enginarslangezici/ECU/KENDİ_ECU.kicad_pcb

## KiCad design KENDİ_ECU.kicad_pcb (2026-10-06)

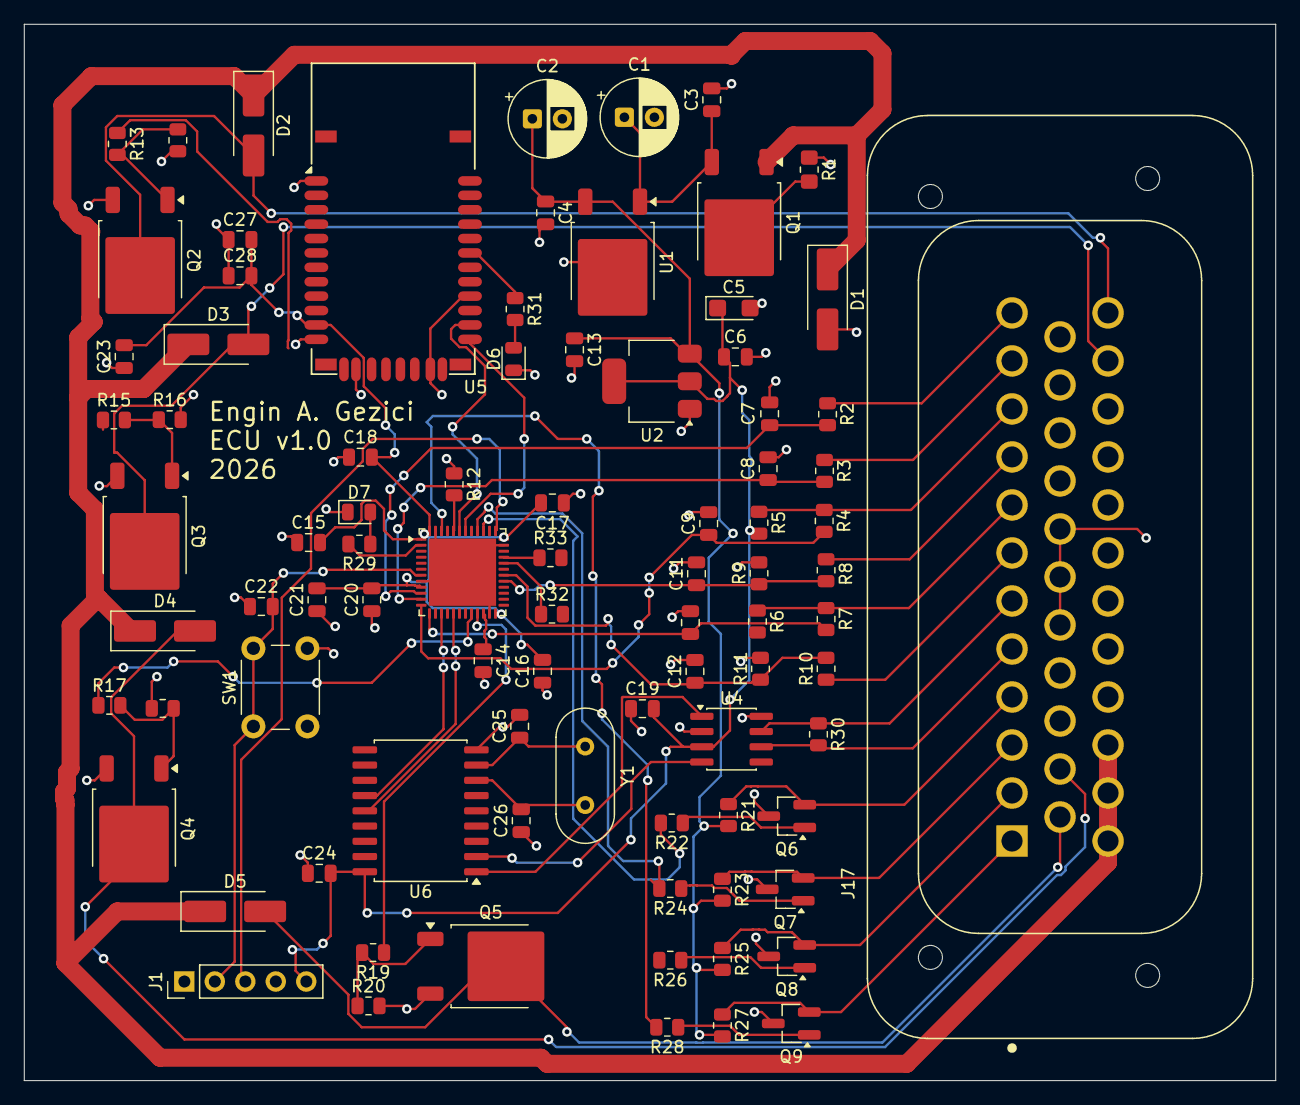
[picture p3: board KENDİ_ECU.kicad_pcb from above]

Board: 2 copper layers, 104.3 x 88.0 mm, 87 parts (0 on the bottom side), 65 nets.

Parts:
C1, C2: 22uF; CP_Radial_D6.3mm_P2.50mm
C3: 330nF; C_0805_2012Metric
C4, C6, C7, C8, C9, C10, C13, C15, C16, C17, C18, C21, C22, C23, C24, C28: 100nF; C_0805_2012Metric
C5: 22uF; CP_EIA-3216-18_Kemet-A
C11, C12: 1nF; C_0805_2012Metric
C14: 2.2uF; C_0805_2012Metric
C19: 4.7uF; C_0805_2012Metric
C20: 1uF; C_0805_2012Metric
C25, C26: 22pF; C_0805_2012Metric
C27: 10uF; C_0805_2012Metric
D1: D_TVS; D_SMA_Handsoldering
D2, D3, D4, D5: D_Schottky; D_SMA_Handsoldering
D6, D7: LED; LED_0805_2012Metric
J1: Conn_01x05; PinHeader_1x05_P2.54mm_Vertical
J17: 776231-1; TE_776231-1
Q1: Q_PMOS_DGS; TO-252-2
Q2, Q3, Q4, Q5: Q_NMOS_GDS; TO-252-2
Q6, Q7, Q8, Q9: Q_NPN_BCE; SOT-23_Handsoldering
R1: 10K; R_0805_2012Metric_Pad1.20x1.40mm_HandSolder
R2, R3, R4, R7, R29, R31: 1K; R_0805_2012Metric
R5, R6, R8, R10: 2.2K; R_0805_2012Metric
R9, R11: 3.3k; R_0805_2012Metric
R12, R14, R16, R18, R20, R32, R33: 10K; R_0805_2012Metric
R13, R15, R17, R19: 330Ω; R_0805_2012Metric
R21, R22, R23, R24, R25, R26, R27, R28: 1kΩ; R_0805_2012Metric
R30: 120Ω; R_0805_2012Metric
SW1: SW_Push; SW_PUSH_6mm
U1: L7805; TO-252-2
U2: AMS1117-3.3; SOT-223-3_TabPin2
U3: STM32F401CCUx; QFN-48-1EP_7x7mm_P0.5mm_EP5.6x5.6mm
U4: SN65HVD230; SOIC-8_3.9x4.9mm_P1.27mm
U5: RN42
U6: MCP2515-xSO; SOIC-18W_7.5x11.6mm_P1.27mm
Y1: 8MHz; Crystal_HC49-4H_Vertical

Connections:
12V_AKU: D1.1 (A1), D2.1 (K), D3.1 (K), D4.1 (K), D5.1 (K), J17.24, J17.25, J17.26, Q1.1 (D)
+3V3: C5.1, C6.1, C15.2, C16.2, C17.2, C18.2, C19.2, C20.2, C21.2, C23.2, C24.2, C27.2, C28.2, J1.5, R5.2, R6.2, R32.2, R33.2, U2.2 (VO), U3.1 (VBAT), U3.9 (VREF+), U3.24 (VDD), U3.36 (VDD), U3.48 (VDD), U4.3 (VCC), U5.11 (VDD), U6.18 (VDD)
+5V: C2.1, C4.1, C13.1, R21.2, R23.2, R25.2, R27.2, U1.3 (OUT), U2.3 (VI)
BT_RX: U3.42 (PB6), U5.13 (UART_RX)
BT_TX: U3.43 (PB7), U5.14 (UART_TX)
CAM_DIGITAL: C12.1, R10.2, R11.1, U3.30 (PA9)
CAN_CS: U3.14 (PA4), U6.16 (~CS)
CAN_H: J17.6, R30.1, U4.7 (CANH)
CAN_INT: R32.1, U3.32 (PA11), U6.12 (~INT)
CAN_L: J17.5, R30.2, U4.6 (CANL)
CAN_RESET: R33.1, U3.33 (PA12), U6.17 (~RESET)
CAN_RX: U4.4 (R), U6.2 (RXCAN)
CAN_TX: U4.1 (D), U6.1 (TXCAN)
CLT_ADC: C9.1, R4.2, U3.12 (PA2)
CRANK_DIGITAL: C11.1, R8.2, R9.1, U3.29 (PA8)
ENJ_1: D2.2 (A), J17.35, Q2.2 (D)
ENJ_2: D3.2 (A), J17.34, Q3.2 (D)
ENJ_3: D4.2 (A), J17.14, Q4.2 (D)
ENJ_4: D5.2 (A), J17.13, Q5.2 (D)
GND: C1.2, C2.2, C3.2, C4.2, C5.2, C6.2, C7.2, C8.2, C9.2, C10.2, C11.2, C12.2, C13.2, C14.2, C15.1, C16.1, C17.1, C18.1, C19.1, C20.1, C21.1, C22.1, C23.1, C24.1, C25.2, C26.1, C27.1, C28.1, D1.2 (A2), D6.1 (K), D7.1 (K), J1.1, J17.17, J17.18, J17.19, Q2.3 (S), Q3.3 (S), Q4.3 (S), Q5.3 (S), Q6.3 (E), Q7.3 (E), Q8.3 (E), Q9.3 (E), R1.1, R9.2, R11.2, R12.1, R14.2, R16.2, R18.2, R20.2, SW1.2, U1.2 (GND), U2.1 (GND), U3.8 (VSSA), U3.23 (VSS), U3.35 (VSS), U3.47 (VSS), U3.49 (VSS), U4.2 (GND), U4.8 (Rs), U5.1 (GND), U5.12 (GND), U5.16 (UART_CTS), U5.28 (GND), U5.29 (GND), U6.9 (VSS)
IAT_ADC: C10.1, R7.2, U3.13 (PA3)
IGN1_CTRL: R22.2, U3.39 (PB3)
IGN2_CTRL: R24.2, U3.40 (PB4)
IGN3_CTRL: R26.2, U3.41 (PB5)
IGN4_CTRL: R28.2, U3.46 (PB9)
IGN_1: J17.4, Q6.2 (C), R21.1
IGN_2: J17.3, Q7.2 (C), R23.1
IGN_3: J17.2, Q8.2 (C), R25.1
IGN_4: J17.1, Q9.2 (C), R27.1
INJ1_CTRL: R13.1, U3.18 (PB0)
INJ2_CTRL: R15.1, U3.19 (PB1)
INJ3_CTRL: R17.1, U3.20 (PB2)
INJ4_CTRL: R19.1, U3.21 (PB10)
IN_CAM: J17.7, R10.1
IN_CLT: J17.10, R4.1, R5.1
IN_CRANK: J17.9, R8.1
IN_IAT: J17.8, R6.1, R7.1
IN_MAP: J17.11, R3.1
IN_TPS: J17.12, R2.1
MAP_ADC: C8.1, R3.2, U3.11 (PA1)
NRST: C22.2, J1.2, SW1.1, U3.7 (NRST)
unnamed: D6.2 (A), R31.2
unnamed: D7.2 (A), R29.1
unnamed: Q1.2 (G), R1.2
unnamed: C1.1, C3.1, Q1.3 (S), U1.1 (IN)
unnamed: Q2.1 (G), R13.2, R14.1
unnamed: Q3.1 (G), R15.2, R16.1
unnamed: Q4.1 (G), R17.2, R18.1
unnamed: Q5.1 (G), R19.2, R20.1
unnamed: Q6.1 (B), R22.1
unnamed: Q7.1 (B), R24.1
unnamed: Q8.1 (B), R26.1
unnamed: Q9.1 (B), R28.1
unnamed: R12.2, U3.44 (BOOT0)
unnamed: R29.2, U3.2 (PC13)
unnamed: C14.1, U3.22 (VCAP1)
unnamed: R31.1, U5.19 (GPIO2)
unnamed: C25.1, U6.8 (OSC1), Y1.1
unnamed: C26.2, U6.7 (OSC2), Y1.2
SPI1_MISO: U3.16 (PA6), U6.15 (SO)
SPI1_MOSI: U3.17 (PA7), U6.14 (SI)
SPI1_SCK: U3.15 (PA5), U6.13 (SCK)
SWCLK: J1.3, U3.37 (PA14)
SWDIO: J1.4, U3.34 (PA13)
TPS_ADC: C7.1, R2.2, U3.10 (PA0)
